Aru123321/KiCad/SEWCS_Commercial_v1.kicad_pcb

## KiCad design SEWCS_Commercial_v1.kicad_pcb (2026-06-29)

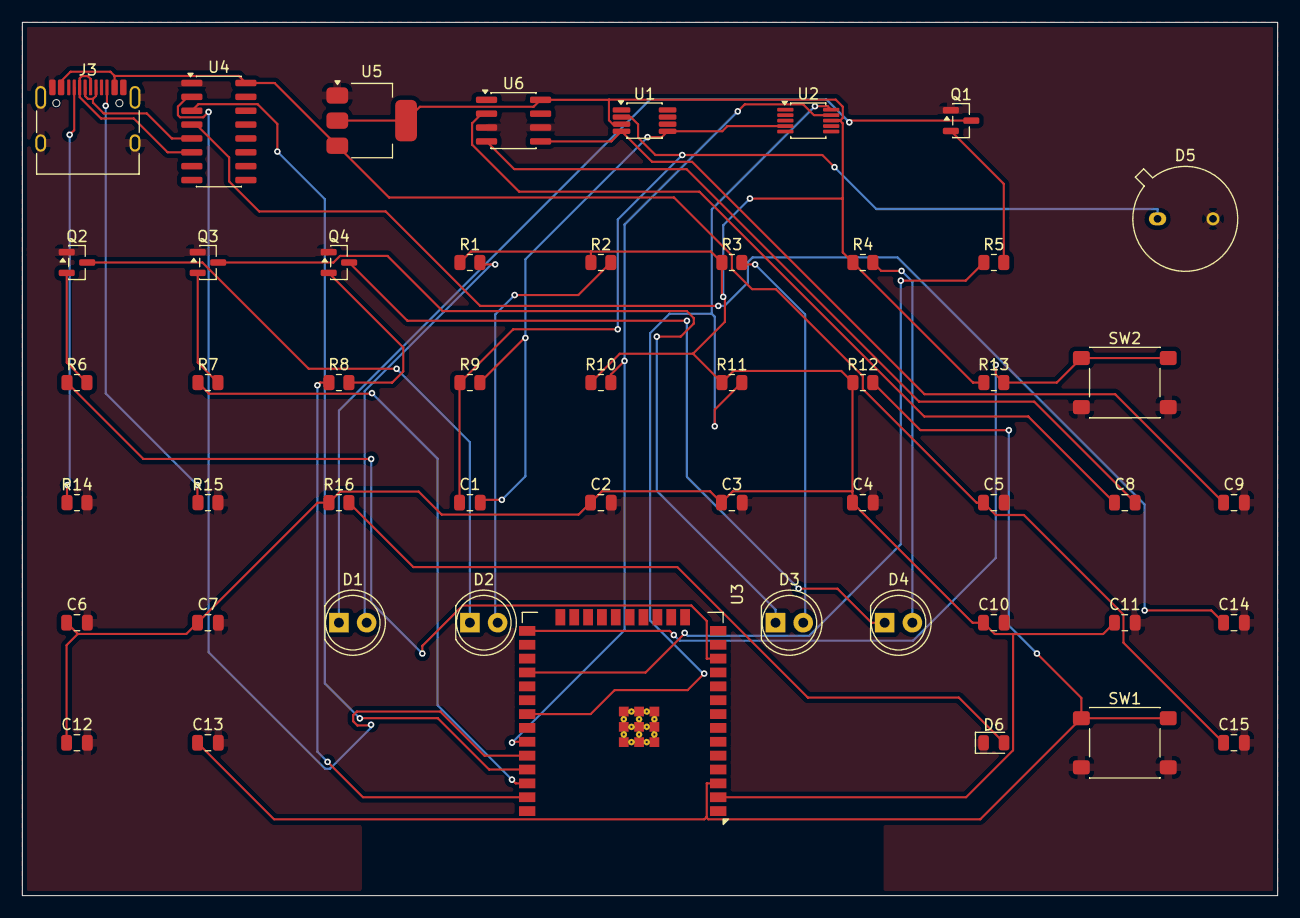
[picture p1: board SEWCS_Commercial_v1.kicad_pcb from above]

Board: 2 copper layers, 115.0 x 80.0 mm, 50 parts (0 on the bottom side), 36 nets.

Parts:
C1: 2.2p; C_0805_2012Metric
C2, C3, C7, C10, C11, C13, C14, C15: 100n; C_0805_2012Metric
C4, C5, C8, C9, C12: 10u; C_0805_2012Metric
C6: 22u; C_0805_2012Metric
D1: LED910L; LED_D5.0mm
D2: LED1085L; LED_D5.0mm
D3: LED1300L; LED_D5.0mm
D4: LED1600L; LED_D5.0mm
D5: FDG05; TO-5-2_Window
D6: PWR; LED_0805_2012Metric
J3: USB-C; USB_C_Receptacle_HRO_TYPE-C-31-M-12
Q1, Q2, Q3, Q4: 2N7002; SOT-23
R1: 150; R_0805_2012Metric
R2: 180; R_0805_2012Metric
R3: 200; R_0805_2012Metric
R4: 220; R_0805_2012Metric
R5, R6, R7, R8: 100; R_0805_2012Metric
R9: 100k; R_0805_2012Metric
R10, R11, R12, R13: 10k; R_0805_2012Metric
R14, R15: 5.1k; R_0805_2012Metric
R16: 1k; R_0805_2012Metric
SW1: RESET; SW_SPST_PTS645Sx43SMTR92
SW2: BOOT; SW_SPST_PTS645Sx43SMTR92
U1: OPA380AID; VSSOP-8_3x3mm_P0.65mm
U2: ADS1115_Breakout; MSOP-10_3x3mm_P0.5mm
U3: ESP32-WROOM-32E
U4: CH340C; SOIC-16_3.9x9.9mm_P1.27mm
U5: AMS1117-3.3; SOT-223-3_TabPin2
U6: ICL7660; SOIC-8_3.9x4.9mm_P1.27mm

Connections:
+3V3: C2.1, C3.1, C4.1, C6.1, C7.1, C10.1, C11.1, C12.1, R1.1, R2.1, R3.1, R4.1, R10.1, R11.1, R12.1, R13.1, R16.1, U1.3, U2.8, U3.2, U5.2, U6.8
+5V: C5.1, C15.1, J3.A4, J3.A9, J3.B4, J3.B9, U4.16, U5.3
-3V3: C9.1, U1.4, U6.5
CC1: J3.A5, R14.1
CC2: J3.B5, R15.1
CP_MINUS: C8.2, U6.4
CP_PLUS: C8.1, U6.2
EN: C13.1, R12.2, SW1.1, U3.3
ESP_RX: U3.34, U4.2
ESP_TX: U3.35, U4.3
GND: C2.2, C3.2, C4.2, C5.2, C6.2, C7.2, C9.2, C10.2, C11.2, C12.2, C13.2, C14.2, C15.2, D5.2, D6.1, J3.A1, J3.A12, J3.B1, J3.B12, J3.SH, Q1.1, Q2.1, Q3.1, Q4.1, R14.2, R15.2, SW1.2, SW2.2, U1.1, U2.1, U2.3, U4.1, U5.1, U6.3, U6.6
GPIO17: R5.1, U3.28
GPIO22: R7.1, U3.36
GPIO23: R8.1, U3.37
GPIO27: R6.1, U3.12
I2C_SCL: R11.2, U2.10, U3.31
I2C_SDA: R10.2, U2.9, U3.33
IO0: R13.2, SW2.1, U3.25
LED910_A: D1.2, R1.2
LED910_K: D1.1, Q1.3
LED1085_A: D2.2, R2.2
LED1085_K: D2.1, Q2.3
LED1300_A: D3.2, R3.2
LED1300_K: D3.1, Q3.3
LED1600_A: D4.2, R4.2
LED1600_K: D4.1, Q4.3
PD_SIG: C1.1, D5.1, R9.1, U1.2
PWR_LED: D6.2, R16.2
Q1_GATE: Q1.2, R5.2
Q2_GATE: Q2.2, R6.2
Q3_GATE: Q3.2, R7.2
Q4_GATE: Q4.2, R8.2
TIA_OUT: C1.2, R9.2, U1.5, U2.4
USB_DM: J3.A7, J3.B7, U4.6
USB_DP: J3.A6, J3.B6, U4.5
V3_CH340: C14.1, U4.4
