Aru123321/KiCad/(commit log)

2026-06-29 Add commercial ESP32 board (SEWCS_Commercial_v1): schematic, routed PCB, fab package, BOM; knowledge base; gitignore
    [SEWCS_Commercial_v1-BOM.csv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]
2026-06-29 Add JLCPCB-ready PCBA BOM with LCSC part numbers; optics marked DNP
    [SEWCS_Commercial_v1-BOM-JLCPCB.csv]
2026-07-07 Add JLCPCB-format CPL (placement) file
    [SEWCS_Commercial_v1-CPL-JLCPCB.csv]
